AEFeinstein/Super-2022-Swadge-HW/art/guidebar.FCStd

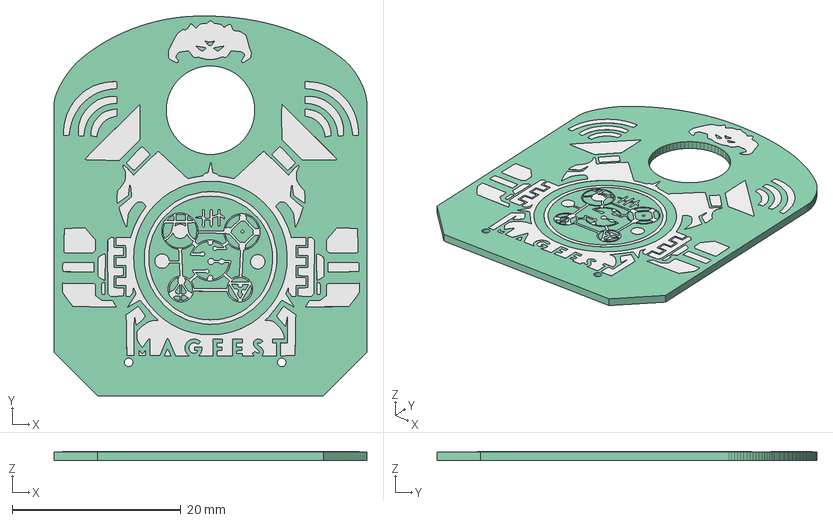
[picture p3: CAD file, 2020-06-11]
art/guidebar.FCStd
37.1 x 45.1 x 1.01 mm
Pcb_2f9
