AEFeinstein/Super-2022-Swadge-HW/art/blade-plate.FCStd

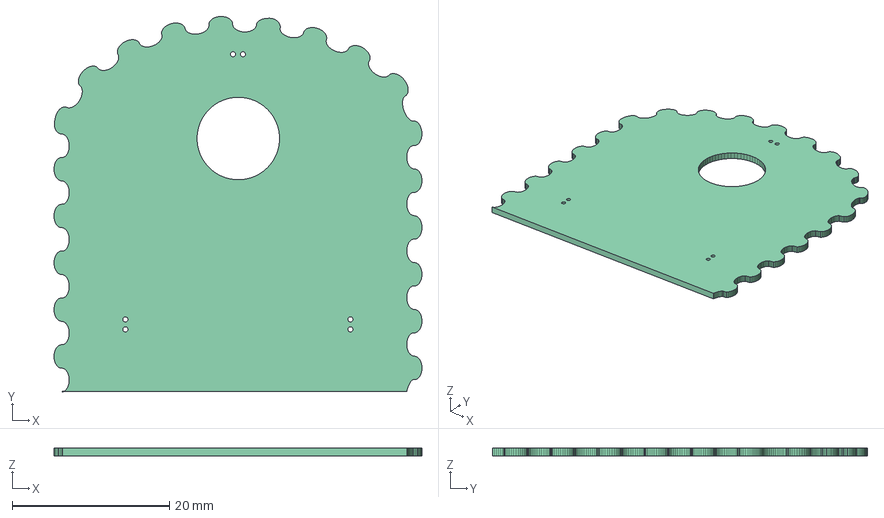
[picture p4: CAD file, 2020-05-10]
art/blade-plate.FCStd
46.9 x 47.8 x 1.00 mm
