AEFeinstein/Super-2022-Swadge-HW/(commit log)

2020-05-09 Added submodule
    [Swadge-2021.kicad_pcb, Swadge-2021.sch]
2020-05-09 Added Devkit Addon project
    [Devkit-Addon.kicad_pcb, Devkit-Addon.sch]
2020-05-09 Added chainsaw outline
    [Swadge-2021.kicad_pcb]
2020-05-09 Added schematic
    [Swadge-2021.sch]
2020-05-09 Fixed up schematic, outline
    [Swadge-2021.kicad_pcb, Swadge-2021.sch]
2020-05-09 Routed board
    [Swadge-2021.kicad_pcb, Swadge-2021.sch]
2020-05-09 Moved OLED
    [Swadge-2021.kicad_pcb, Swadge-2021.sch]
2020-05-10 Shifted parts, again
    [Swadge-2021.kicad_pcb]
2020-05-10 added art
    [blade-plate.step]
2020-05-10 added blade-plate to sch/pcb
    [Swadge-2021.kicad_pcb, Swadge-2021.sch]
2020-05-10 Added more art
    [blade-plate.FCStd]
2020-05-10 Removed generated files
    [blade-plate.step]
2020-05-10 Added Blade Plate project Updated Swadge-2021 with blade plate & less copper around antenna
    [Swadge-2021.kicad_pcb, blade-plate-outline.kicad_pcb, blade-plate.FCStd]
2020-05-10 Make traces a little cleaner
    [Swadge-2021.kicad_pcb]
2020-05-14 Added art and PCB for blade plate with window
    [blade-plate-outline.kicad_pcb]
2020-05-14 Replaced WRL with STEP in Swadge-2021.kicad_pcb where possible
    [Swadge-2021.kicad_pcb]
2020-05-14 Updated OLED 3D model
    [Swadge-2021.kicad_pcb]
2020-05-16 Added another chainsaw outline
2020-05-16 Imported new chainsaw outline
    [Swadge-2021.kicad_pcb]
2020-05-17 Laid out parts on second outline Added blade-plate-no-teeth
    [Swadge-2021.kicad_pcb, Swadge-2021.sch, blade-plate-no-teeth.kicad_pcb]
2020-05-17 Added blade-plate-no-teeth art
2020-05-17 Shrank chainsaw body to put PCIE and batteries closer
    [Swadge-2021.kicad_pcb]
2020-05-17 Sttempt to fix microphone CAD
    [Swadge-2021.kicad_pcb]
2020-05-17 Made chainsaw a little wider to move the batteries down a little further
    [Swadge-2021.kicad_pcb, Swadge-2021.sch]
2020-05-17 Added blade-plate-small to the PCB Added blade-plate-small project
    [Swadge-2021.kicad_pcb, Swadge-2021.sch, blade-plate-small.kicad_pcb]
2020-05-19 Added blade-plate-small-no-teeth project Added blade-plate-small-no-teeth to Swadge-2021
    [Swadge-2021.kicad_pcb, Swadge-2021.sch, blade-plate-small-no-teeth.kicad_pcb]
2020-05-19 started routing
    [Swadge-2021.kicad_pcb]
2020-05-20 Added blade-plate-med-no-teeth project Added blade-plate-med-no-teeth to Swadge-2021
    [Swadge-2021.kicad_pcb, Swadge-2021.sch, blade-plate-med-no-teeth.kicad_pcb]
2020-05-20 Moved notch near power switch
    [Swadge-2021.kicad_pcb]
2020-05-20 Rerouted board for better antenna clearance
    [Swadge-2021.kicad_pcb]
2020-05-20 Moved button references, routed
    [Swadge-2021.kicad_pcb, Swadge-2021.sch]
2020-05-21 Rerouted amp
    [Swadge-2021.kicad_pcb]
2020-05-21 Added edge plating? Tweaked routing!
    [Swadge-2021.kicad_pcb]
2020-05-21 Updated edge plating
    [Swadge-2021.kicad_pcb]
2020-05-21 Cleaned up edge plating
    [Swadge-2021.kicad_pcb]
2020-05-22 Chamfered blade-plate-no-teeth-outline
2020-05-23 Prep for BOM Adjusted LED positions Adjusted hole size for blade-plate-med-no-teeth/blade-plate-med-no-teeth
    [Swadge-2021.kicad_pcb, Swadge-2021.sch, blade-plate-med-no-teeth.kicad_pcb]
2020-05-23 Updated references
    [Swadge-2021.kicad_pcb]
2020-05-24 Fattened traces Added version silkscreen, initials
    [Swadge-2021.kicad_pcb]
2020-05-24 RFQ prep
    [Swadge-2021.kicad_pcb, blade-plate-med-no-teeth.kicad_pcb]
2020-05-28 Updated microphone circuit
    [Swadge-2021.kicad_pcb, Swadge-2021.sch]
2020-06-05 Ignore mfg directories
    [Swadge-2021.kicad_pcb, blade-plate-med-no-teeth.kicad_pcb]
2020-06-11 Added art to PCB
    [Swadge-2021.kicad_pcb, guidebar.FCStd]
2020-06-15 Fixed resistor value, removed PCIe socket from BOM
    [Swadge-2021.kicad_pcb, Swadge-2021.sch]
2020-06-16 Cleaned up SVGs Added art to blade-plate-med-no-teeth/blade-plate-med-no-teeth Updated art on Swadge-2021
    [Swadge-2021.kicad_pcb, blade-plate-med-no-teeth.kicad_pcb]
2020-06-17 Redid vector art for guide bar
    [blade-plate-med-no-teeth.kicad_pcb]
2020-06-17 Redid vecot art for body
    [Swadge-2021.kicad_pcb]
2020-06-17 Updated PCB version
    [Swadge-2021.kicad_pcb]
2020-06-18 Added split art to guidebar
    [blade-plate-med-no-teeth.kicad_pcb]
2020-07-30 Made lanyard hole 7mm Flattened out bottom Silkscreen "BAT USB" for the switch Updated silkscreen version Added silkscreen email Moved signature
    [Swadge-2021.kicad_pcb]
2020-08-02 Updated guide bar with LED runes
    [blade-plate-med-no-teeth.kicad_pcb]
2020-08-02 Added b.mask to guide-bar
    [blade-plate-med-no-teeth.kicad_pcb]
2020-08-25 Updated guide-bar
    [blade-plate-med-no-teeth.kicad_pcb]
2020-10-30 Added URL and "pwr only" silkscreen to PCB
    [Swadge-2021.kicad_pcb]
2020-11-06 Generated gerbers
    [Swadge-2021.kicad_pcb]
2020-11-12 Added a little redundant metal on the guide bar between the batteries
    [blade-plate-med-no-teeth.kicad_pcb]
2020-11-16 Added resist to back of guide bar
    [blade-plate-med-no-teeth.kicad_pcb]
2020-11-16 Fix warnings
    [Swadge-2021.kicad_pcb, blade-plate-med-no-teeth.kicad_pcb]
2020-12-30 Change guidebar text
    [blade-plate-med-no-teeth.kicad_pcb]
2021-01-01 Update guide bar art
    [blade-plate-med-no-teeth.kicad_pcb]
2021-01-05 Updated silkscreen
    [Swadge-2021.kicad_pcb]
2021-08-03 Revert guide bar
    [blade-plate-med-no-teeth.kicad_pcb]
2021-08-03 Revert silkscreen on swadge
    [Swadge-2021.kicad_pcb]
